Lwao/DAQ_ECG/README.md

# Experimental data acquisition and processing system for ECG signals
