Lwao/DAQ_ECG/beamer/main.tex

%\documentclass[10pt]{beamer} % 4/3 aspect ration works as well
\documentclass[10pt,aspectratio=169]{beamer}
%----------------------------------------------------------------------------------------
%	PACKAGES AND THEMES
%----------------------------------------------------------------------------------------

\mode<presentation>{
  \usetheme{EuXFEL}
  \usecolortheme{EuXFEL}
}

\usepackage{amsmath}
\usepackage{helvet}
\usepackage[utf8]{inputenc}
\usepackage[portuguese]{babel} 
\usepackage{tikz}
\usetikzlibrary{shapes, arrows, calc, positioning}
\usetikzlibrary{decorations.pathreplacing}
\usepackage{amsmath,amssymb}%,amsthm,amsxtra,mathabx}
\usepackage{lipsum}
\usepackage{verbatim}
\usepackage{datetime}
\usepackage{amsmath, amsfonts, amssymb} 
\usepackage{graphicx, float} 
\usepackage{hyperref}
\usepackage[absolute,overlay]{textpos}
\usepackage[texcoord]{eso-pic}
\usepackage{tabularx}
\usepackage{float}
\usepackage{adjustbox}
%\usepackage{natbib}
\usepackage{bibentry}
\usepackage{graphicx} % Allows including images
\usepackage{booktabs} % Allows the use of \toprule, 

\usepackage{booktabs, multirow} % for borders and merged ranges
\usepackage{soul}% for underlines
\usepackage[table]{xcolor} % for cell colors
\usepackage{changepage,threeparttable} % for wide tables

\definecolor{links}{HTML}{2A1B81}
\hypersetup{colorlinks,linkcolor=,urlcolor=links}

\renewcommand{\familydefault}{\sfdefault}
\renewcommand\mathfamilydefault{}
\newcommand{\colorbf}[1]{{\color{xOrange}\textbf{#1}}}

\newdateformat{dmydate}{%
    \twodigit{\THEDAY}~\monthname[\THEMONTH] \THEYEAR
%    \dayofweekname{\THEDAY}{\THEMONTH}{\THEYEAR} \twodigit{\THEDAY}~\monthname[\THEMONTH] \THEYEAR      
}   

\title[DAQ - ECG]{Experimental data acquisition and processing system for ECG signals}

\author{Levy G. S. Galvão }

\date{\dmydate\today} 

\setbeamersize{text margin left=.05\pdfpagewidth,text margin right=.05\pdfpagewidth}

\begin{document}
{
  \setbeamertemplate{headline}{}
  \begin{frame}
    \titlepage
   \end{frame}
}

{
  \begin{frame}
    \frametitle{Contents}
    \tableofcontents
  \end{frame}
}

\AtBeginSection[]
{
  \begin{frame}
    \frametitle{Contents}
    \tableofcontents[currentsection]
  \end{frame}
}

\input{body}
\end{document}
