Lwao/DAQ_ECG/beamer/body/04.tex

\section{Next steps}

\begin{frame}{Next steps}
\begin{column}{\textwidth}
        \begin{itemize}
            \item Implement the ECG simulator with a better DAC;
            \item Implement the analog front-end in hardware and validate the wave forms in each node with oscilloscopes;
            \item Use an external ADC with higher bit resolution and conditioning circuit to address its input to the ADC linear region;
            \item Transmit the data via wireless protocol via internet;
            \item Test new topologies for the analog front-end, such as: multistage amplifiers, higher order filters etc.;
            \item Further enhance the DAQ DSP section;
        \end{itemize}
\end{column}{\textwidth}
\end{frame}
