Lwao/DAQ_ECG/beamer/body/bib.tex

\begin{frame}
\frametitle{References}
\footnotesize{
\begin{thebibliography}{99} 

\bibitem[Khandpur, 2019]{khandpur2019compendium} Raghbir Khandpur (2019)
\newblock Compendium of Biomedical Instrumentation
\newblock John Wiley \& Sons

\bibitem[Khandpur, 2005]{khandpur2005biomedical} Raghbir Khandpur (2005)
\newblock Compendium of Biomedical Instrumentation
\newblock JMcGraw-Hill New York

\bibitem[Khandpur, 1987]{khandpur1987handbook} Raghbir Khandpur (1987)
\newblock Handbook of biomedical instrumentation
\newblock McGraw-Hill Education

\end{thebibliography}
}
\end{frame}

\begin{frame}
\frametitle{References}
\footnotesize{
\begin{thebibliography}{99} 

\bibitem[Sahin, 2020]{sahin2020instrumentation} Mesut Sahin (2020)
\newblock Instrumentation Handbook for Biomedical Engineers
\newblock CRC Press

\bibitem[Murugappan, 2014]{murugappan2014development} Murugappan M. \textit{et al} (2014)
\newblock Development of cost effective ECG data acquisition system for clinical applications using LabVIEW
\newblock IEEE

\bibitem[Quiroz, 2019]{quiroz2019generation} Quiroz-Ju{\'a}rez (2014)
\newblock Generation of ECG signals from a reaction-diffusion model spatially discretized
\newblock Nature Publishing Group

\end{thebibliography}
}
\end{frame}

%\bibitem[, ]{} ()
%\newblock 
%\newblock
