Lwao/DAQ_ECG/latex/circuits/bandpass.tex

\begin{figure}[h!]
\begin{center}
\tikz \node [scale=0.75, inner sep=0] {
\begin{tikzpicture} [ american, ]
    \draw (0.3,0) to[short,-*] (0,0) 
    (0.3,0) to[R,l_=$R_{B1}$, -] (2.3,0)
    (2.3,0) to[C,l_=$C_{B1}$, -*] (4.3,0)
    (-0.5,0) node[] {$V_{IN}$}
    ;
    
    \draw (6,-0.5) node[op amp] (opamp1) {}
    (opamp1.+) -- (4.3,-1)  
    (opamp1.-) -- (4.3,0)
    (opamp1.out) --  (8.3,-0.5) node[right] {$V_{OUT}$}
    (4.3,-1) -- (4.3,-2) node[ground] {}
    ;
    
    \draw (4.3,1.5) to[R,l_=$R_{B2}$, *-*] (7.2,1.5)
    (4.3,3) to[C,l_=$C_{B2}$, -] (7.2,3)
    (4.3,0) -- (4.3,3)
    (7.2,3) to[short, -*] (7.2,-0.5)
    ;

\end{tikzpicture}
};
\end{center}
\caption{Band-pass filter.}
\label{ckt:3} 
\end{figure}
