Lwao/DAQ_ECG/latex/text/pos/appendix.tex

\appendix
\section{Schematics}

\begin{figure}[h!] 
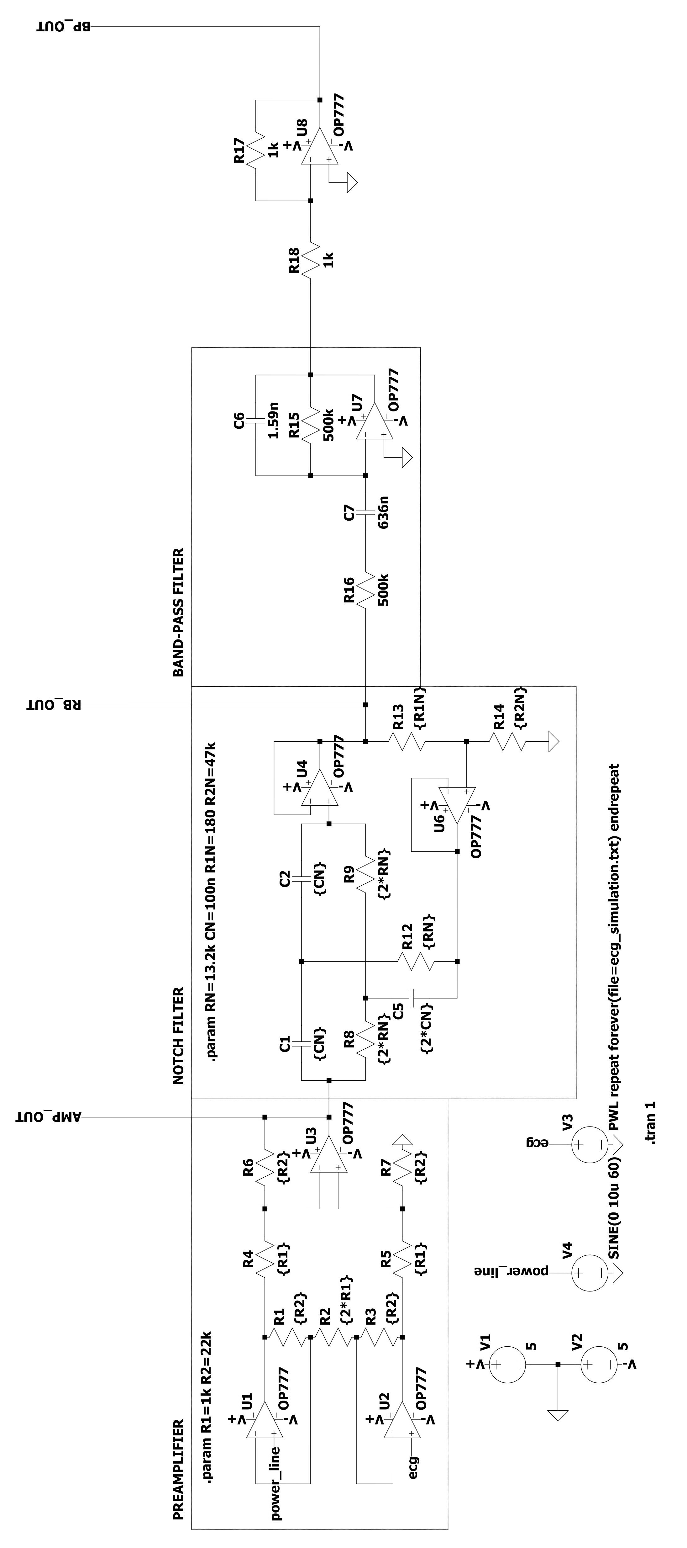
[picture p13: latex/images/afe_rot.jpg]
    
    \caption{Analog front-end LTSpice schematic.}
    \label{fig:appendix:1} 
\end{figure}

\pagebreak
