Lwao/DAQ_ECG/latex/text/pre/cover.tex

\onehalfspacing
\begin{titlepage}
	\begin{center}
	
	\begin{figure}[!ht]
	\centering
	\end{figure}

		\vspace{15pt}
        \vspace{50pt}
        \large{Levy Gabriel da Silva Galvão}\\
		\vspace{3,5cm}
		\textbf{\Large{Experimental data acquisition and processing system for ECG signals}}
	\end{center}

	\vspace{1cm}
	
	\begin{center}
		\vspace{\fill}
		Natal - RN \\ October, 2021
	\end{center}
\end{titlepage}
%%%%%%%%%%%%%%%%%%%%%%%%%%%%%%%%%%%%%%%%%%%%%%%%%%%%%%%%%%%

\newpage
