Lwao/DAQ_ECG/Final_presentation_ECG_DAQ.pdf

# Experimental data acquisition and processing system for ECG signals

Levy G. S. Galvao˜

19 de outubro de 2021

DAQ - ECG | Levy G. S. Galvao | 19 de outubro de 2021 ˜ | 2

## Contents

1 Initial studies

2 Methodology

3 Results

4 Next steps

DAQ - ECG | Levy G. S. Galvao | 19 de outubro de 2021 ˜ | 3

## Contents

1 Initial studies

2 Methodology

3 Results

4 Next steps

DAQ - ECG | Levy G. S. Galvao | 19 de outubro de 2021 ˜ | 4

## Initial studies: bibliographic research


1. Importance of an electrocardiograph (ECG) instrument;
2. Electrical and physical characteristics of an ECG signal;
3. Distortions associated with the ECG;
4. Consolidated data acquisition systems for ECG;
5. User interface with the ECG instrument;

Figura: Normal waveform pattern of cardiac signal obtained in ECG. Source: [Khandpur, 2019].

DAQ - ECG | Levy G. S. Galvao | 19 de outubro de 2021 ˜ | 5

## Initial studies: system specification

1. Amplitude:
ECG signal with 1 mV peak-to-peak [Khandpur, 2019];
Combined distortions with ≈ 10 µV peak-to-peak [Khandpur, 1987]; Solution: preamplifier gain of 500 [Khandpur, 2019] and CMRR > +100dB [Khandpur, 2019, Khandpur, 2005]
2. Frequency range:

Typical range 0.05 to 150 Hz and sampling rate of 300 samples/s; Solution: used sampling rate of 500 samples/s;

3. Quantization:

16-bit or 24-bit ADC [Khandpur, 2019];
Solution: available 12-bit ADC;
4. Typical use of bipolar leads arrangement [Khandpur, 2019];

DAQ - ECG | Levy G. S. Galvao | 19 de outubro de 2021 ˜ | 6

## Initial studies: distortions specifications

1. Power-line interference:
Frequency of 50/60 Hz;
Solution: analog Notch filter;
2. Baseline wanders and muscle contraction:
Range of 0.05 Hz [Khandpur, 2019, Murugappan, 2014] to 0.5 Hz [Sahin, 2020]; Solution: analog high-pass filter;
3. Electromagnetic interference:

Higher frequencies (RF);
Solution: analog low-pass filter;
4. AWGN and aliasing:

Across all frequency range;
Solution: analog low-pass filter and digital moving average filter;

DAQ - ECG | Levy G. S. Galvao | 19 de outubro de 2021 ˜ | 7

## Contents

1 Initial studies

2 Methodology

3 Results

4 Next steps

DAQ - ECG | Levy G. S. Galvao | 19 de outubro de 2021 ˜

8

## System overview


DAQ - ECG | Levy G. S. Galvao | 19 de outubro de 2021 ˜ | 9

## System overview

ECG simulator embedded in an ESP32 microcontroller dev-kit outputting via a built-in 8-bit DAC using the [Quiroz, 2019] model;


Analog front-end simulated via software in LTSpice;

ECG DAQ embedded in another ESP32 dev-kit with:
Built-in 12-bit ADC;
Two cores;
USB interface with Python plotter client; DSP for heart rate computation and pathology analysis;

Figura: Diagram relating the cardiac natural pacemakers to non linear variables. Source: [Quiroz, 2019].

DAQ - ECG | Levy G. S. Galvao | 19 de outubro de 2021 ˜ | 10

## Contents

1 Initial studies

2 Methodology

3 Results

4 Next steps

DAQ - ECG | Levy G. S. Galvao | 19 de outubro de 2021 ˜ | 11

## ECG simulator in 32-bit software vs. 8-bit DAC hardware

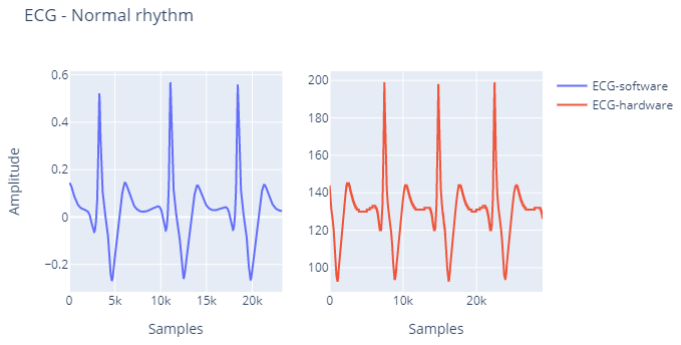
[picture p25: figure]

DAQ - ECG | Levy G. S. Galvao | 19 de outubro de 2021 ˜ | 12

## ECG simulator for multiples pathology configurations

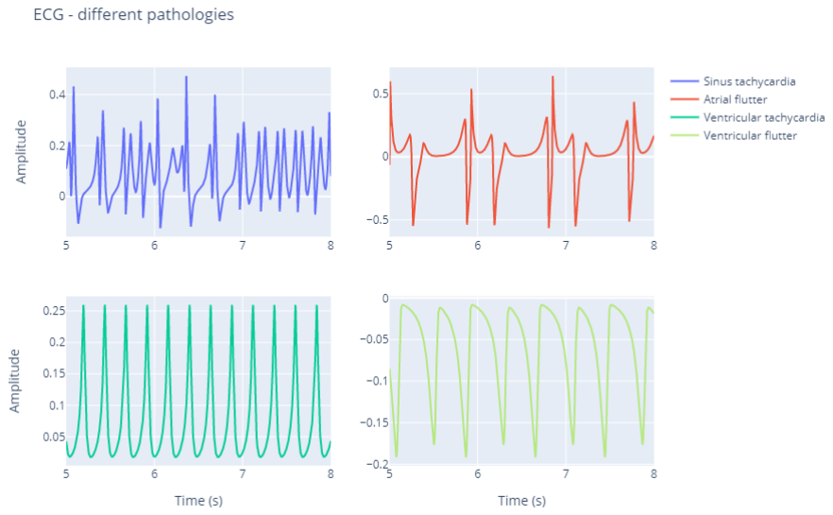
[picture p26: figure]

DAQ - ECG | Levy G. S. Galvao | 19 de outubro de 2021 ˜ | 13

## Analog front-end nodes in time domain

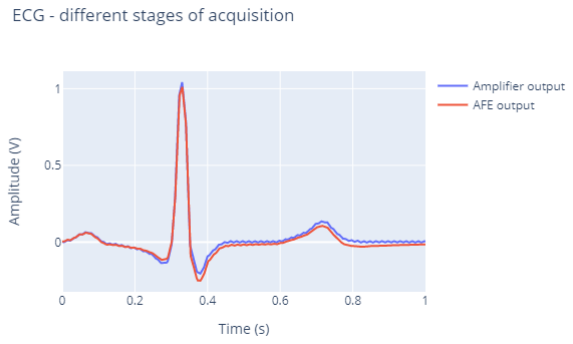
[picture p27: figure]

DAQ - ECG | Levy G. S. Galvao | 19 de outubro de 2021 ˜ | 14

## Analog front-end nodes in frequency domain

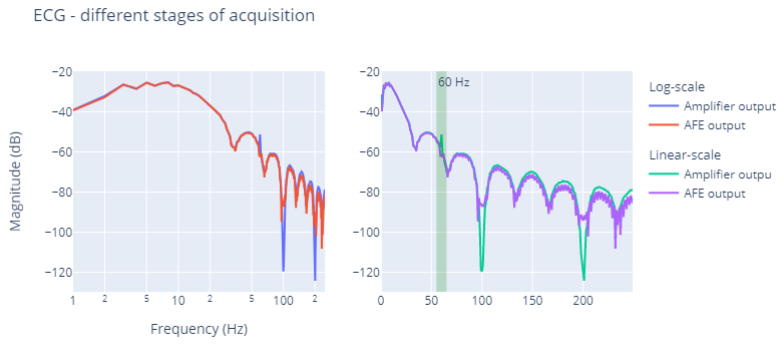
[picture p28: figure]

DAQ - ECG | Levy G. S. Galvao | 19 de outubro de 2021 ˜ | 15

## Heart rate analysis in software


DAQ - ECG | Levy G. S. Galvao | 19 de outubro de 2021 ˜ | 16

## Visualization in Python USB client: noisy ECG

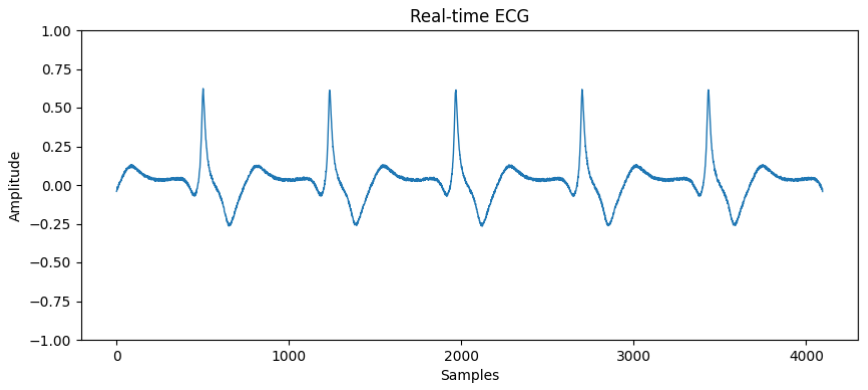
[picture p29: figure]

DAQ - ECG | Levy G. S. Galvao | 19 de outubro de 2021 ˜ | 17

## Visualization in Python USB client: filtered ECG

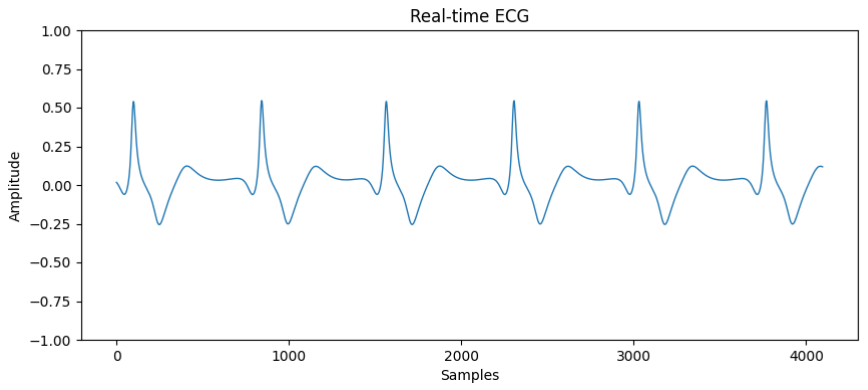
[picture p30: figure]

DAQ - ECG | Levy G. S. Galvao | 19 de outubro de 2021 ˜ | 18

## Visualization in Python USB client: ECG + heart rate

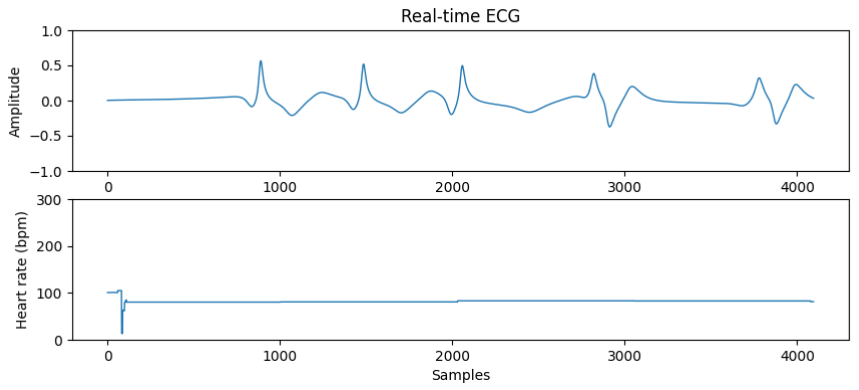
[picture p31: figure]

DAQ - ECG | Levy G. S. Galvao | 19 de outubro de 2021 ˜ | 19

## Contents

1 Initial studies

2 Methodology

3 Results

4 Next steps

DAQ - ECG | Levy G. S. Galvao | 19 de outubro de 2021 ˜ | 20

## Next steps

Implement the ECG simulator with a better DAC;

Implement the analog front-end in hardware and validate the wave forms in each node with oscilloscopes;
Use an external ADC with higher bit resolution and conditioning circuit to address its input to the ADC linear region;

Transmit the data via wireless protocol via internet;

Test new topologies for the analog front-end, such as: multistage amplifiers, higher order filters etc.;
Further enhance the DAQ DSP section;

DAQ - ECG | Levy G. S. Galvao | 19 de outubro de 2021 ˜ | 21

## References

Raghbir Khandpur (2019)
Compendium of Biomedical Instrumentation John Wiley & Sons

Raghbir Khandpur (2005)
Compendium of Biomedical Instrumentation JMcGraw-Hill New York

Raghbir Khandpur (1987)
Handbook of biomedical instrumentation McGraw-Hill Education

DAQ - ECG | Levy G. S. Galvao | 19 de outubro de 2021 ˜ | 22

## References

Mesut Sahin (2020)
Instrumentation Handbook for Biomedical Engineers CRC Press

Murugappan M. et al (2014)
Development of cost effective ECG data acquisition system for clinical applications using LabVIEW IEEE

Quiroz-Juarez (2014) ´
Generation of ECG signals from a reaction-diffusion model spatially discretized Nature Publishing Group
