Lwao/DAQ_ECG/latex/circuits/notch.tex

\begin{figure}[h!]
\begin{center}
\tikz \node [scale=0.75, inner sep=0] {
\begin{tikzpicture} [ american, ]
    \draw (0.3,0) -- (0,0) 
    (0.3,0) to[R,l_=$2R_N$, *-] (3.3,0)
    (3.3,0) to[R,l_=$2R_N$, -*] (6.3,0)
    (0.3,0) -- (0.3,-1.5)
    (6.3,0) -- (6.3,-1.5)
    (0.3,-1.5) to[C,l_=$C_N$, -] (3.3,-1.5)
    (3.3,-1.5) to[C,l_=$C_N$, -] (6.3,-1.5)
    (-0.5,0) node[] {$V_{IN}$}
    ;
    
    \draw (2.3,-1.5) to[R,l_=$R_N$, *-] (2.3,-4.5)
    (4,-1.5) to[C,l_=$2C_N$, -*] (4,-4.5)
    (4,0) to[short,*-] (4,-1.5) 
    (2.3,-4.5) -- (5,-4.5)
    ;

    \draw (8,0.5) node[op amp] (opamp1) {}
    (opamp1.+) -- (6.3,0)  
    (opamp1.-) -- (6.8,2)
    (opamp1.out) --  (10,0.5) node[right] {$V_{OUT}$}
    %(opamp2.up) --++(0,0.005) node[vcc]{15\,\textnormal{V}}
    %(opamp2.down) --++(0,-0.005) node[vee]{-15\,\textnormal{V}}
    (6.8,2) -- (9,2) 
    (9,2) -- (9,0.5)
    (9,0.5) to[R,l_=$R_{1N}$, *-] (9,-5)
    (9,-5) to[R,l_=$R_{2N}$, *-] (9,-7) node[ground] {}
    ;
    
    \draw (7,-4.5) node[op amp, xscale=-1] (opamp2) {}
    (opamp2.+) -- (9,-5) 
    (opamp2.-) -- (8.2,-4)
    (opamp2.out) --  (5,-4.5) 
    (8.2,-4) -- (8.2,-3)
    (8.2,-3) -- (6,-3)
    (6,-3) to[short,-*] (6,-4.5)
    ;

\end{tikzpicture}
};
\end{center}
\caption{Notch filter.}
\label{ckt:2} 
\end{figure}
