Lwao/DAQ_ECG/beamer/images/AFE/afe3.png

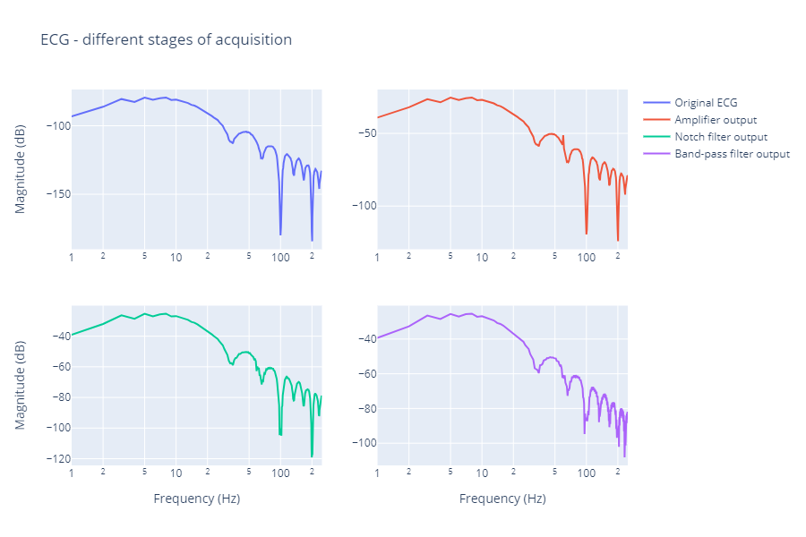
beamer/images/AFE/afe3.png
