Lwao/DAQ_ECG/beamer/images/afe_nor.jpg

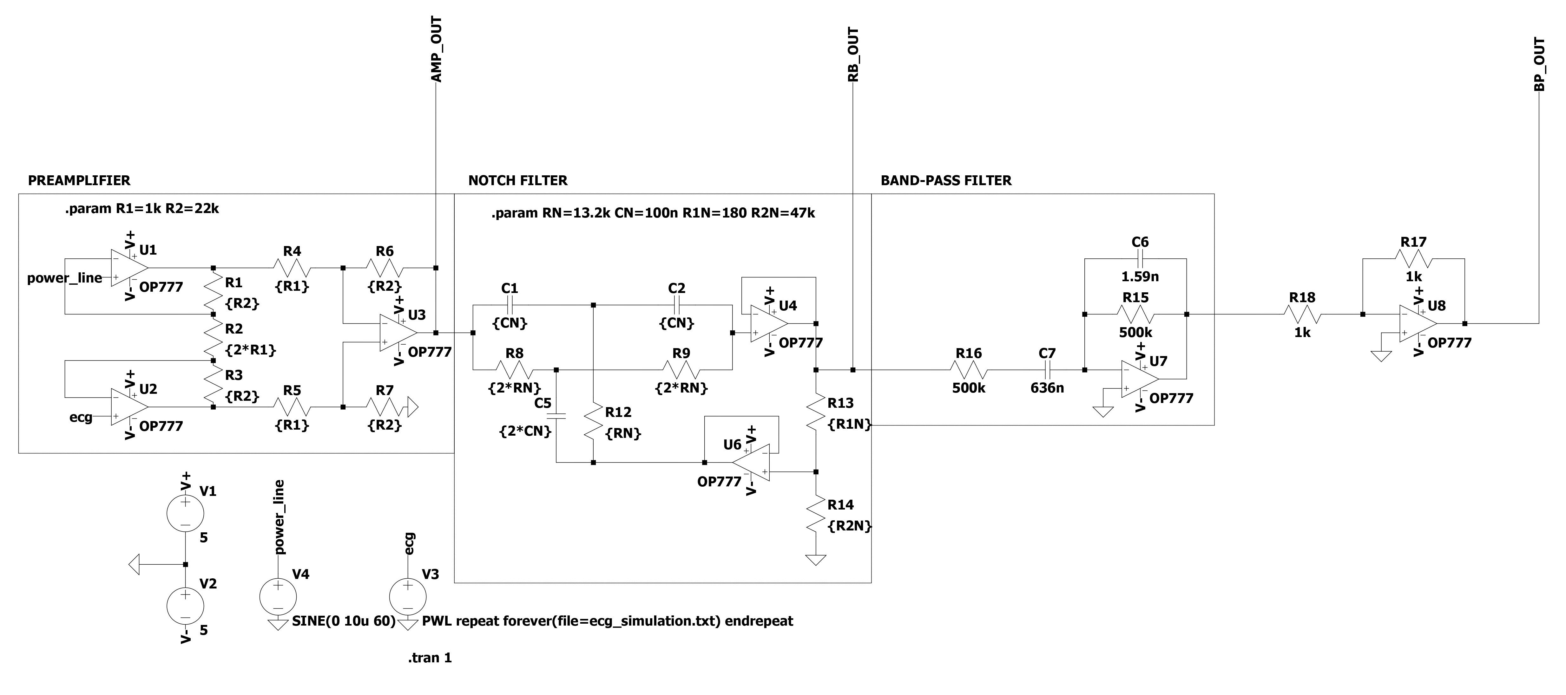
beamer/images/afe_nor.jpg
