Lwao/DAQ_ECG/beamer/images/dsp_pathologies.png

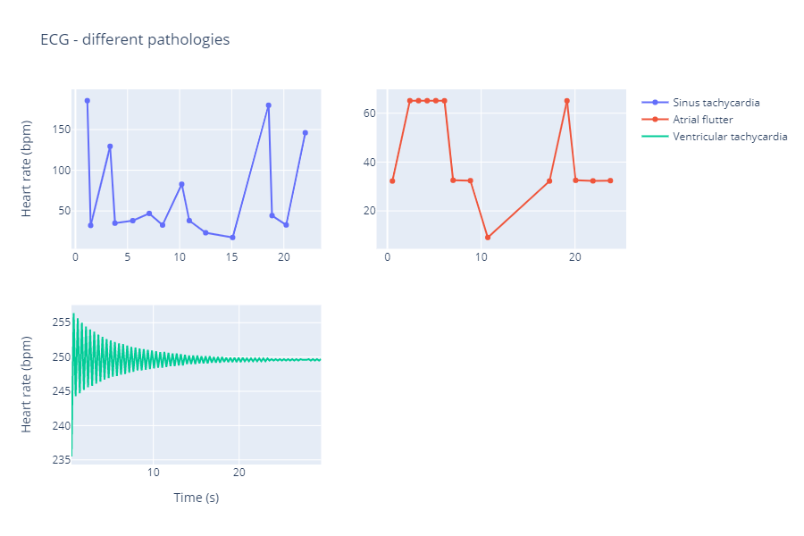
beamer/images/dsp_pathologies.png
