Lwao/DAQ_ECG/python/Test scripts/stored_data_filtered.csv

3.246899999999999786e-02
3.241999999999999743e-02
3.237600000000000200e-02
3.233599999999999669e-02
3.230100000000000332e-02
3.227000000000000007e-02
3.224300000000000083e-02
3.222099999999999964e-02
3.220200000000000146e-02
3.218800000000000133e-02
3.217799999999999827e-02
3.217199999999999921e-02
3.216999999999999721e-02
3.217199999999999921e-02
3.217799999999999827e-02
3.218800000000000133e-02
3.220100000000000046e-02
3.221899999999999764e-02
3.223999999999999783e-02
3.226500000000000201e-02
3.229300000000000226e-02
3.232499999999999957e-02
3.236100000000000088e-02
3.239999999999999825e-02
3.244299999999999962e-02
3.248899999999999705e-02
3.253799999999999748e-02
3.259100000000000191e-02
3.264700000000000241e-02
3.270699999999999996e-02
3.276899999999999952e-02
3.283500000000000307e-02
3.290400000000000269e-02
3.297599999999999837e-02
3.305099999999999705e-02
3.312899999999999873e-02
3.321000000000000341e-02
3.329300000000000315e-02
3.337999999999999995e-02
3.346899999999999875e-02
3.356200000000000155e-02
3.365599999999999842e-02
3.375399999999999928e-02
3.385400000000000215e-02
3.395700000000000107e-02
3.406200000000000200e-02
3.416899999999999799e-02
3.427899999999999697e-02
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
