Lwao/DAQ_ECG/LTSpice/ecg_acquisition.asc

C1: cap; {CN}
C2: cap; {CN}
C5: cap; {2*CN}
C6: cap; 1.59n
C7: cap; 636n
R1: res; {R2}
R2: res; {2*R1}
R3: res; {R2}
R4: res; {R1}
R5: res; {R1}
R6: res; {R2}
R7: res; {R2}
R8: res; {2*RN}
R9: res; {2*RN}
R12: res; {RN}
R13: res; {R1N}
R14: res; {R2N}
R15: res; 500k
R16: res; 500k
R17: res; 1k
R18: res; 1k
U1: OP777
U2: OP777
U3: OP777
U4: OP777
U6: OP777
U7: OP777
U8: OP777
V1: voltage; 5
V2: voltage; 5
V3: voltage; PWL repeat forever(file=ecg_simulation.txt) endrepeat
V4: voltage; SINE(0 10u 60)
Named nets: ecg, 0, V-, V+, power_line, AMP_OUT, RB_OUT, BP_OUT
.param R1=1k R2=22k
.tran 1
.param RN=13.2k CN=100n R1N=180 R2N=47k
PREAMPLIFIER
NOTCH FILTER
BAND-PASS FILTER
