Lwao/DAQ_ECG/LTSpice/ecg_simulation.asc

V1: voltage; PWL repeat forever(file=ecg_simulation.txt) endrepeat
Named nets: 0, ECG
Credits: https://glenzac.wordpress.com/2018/11/09/ecg-sources-for-pspice-tina-multisim/
.tran 10
