Lwao/DAQ_ECG/(commit log)

2021-10-07 Analog front-end circuit
2021-10-09 Filter design in ipynb
2021-10-10 Update data directory
    [stored_ECG.csv, stored_HR.csv, stored_data.csv, stored_data_noisy.csv]
